juli-au/platonic/img/gallery/v1-poster.jpg

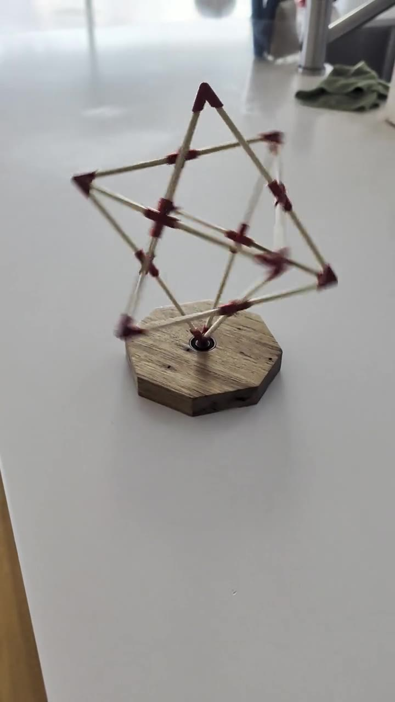
img/gallery/v1-poster.jpg
