juli-au/platonic/img/gallery/g9-thumb.jpg

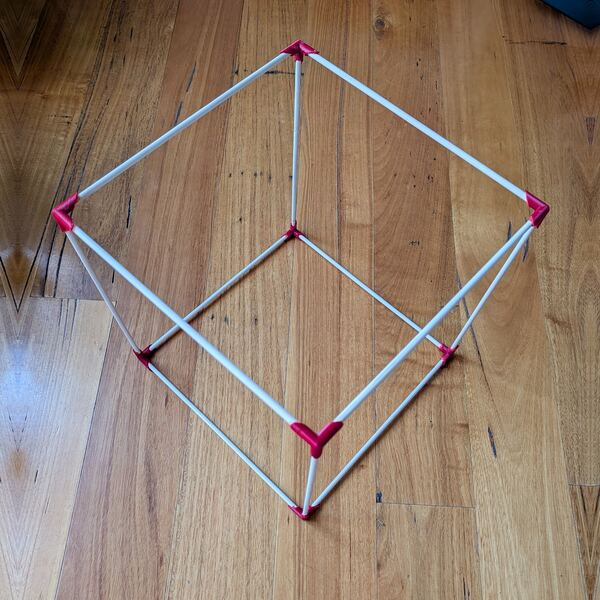
img/gallery/g9-thumb.jpg
