juli-au/platonic/img/gallery/g1-thumb.jpg

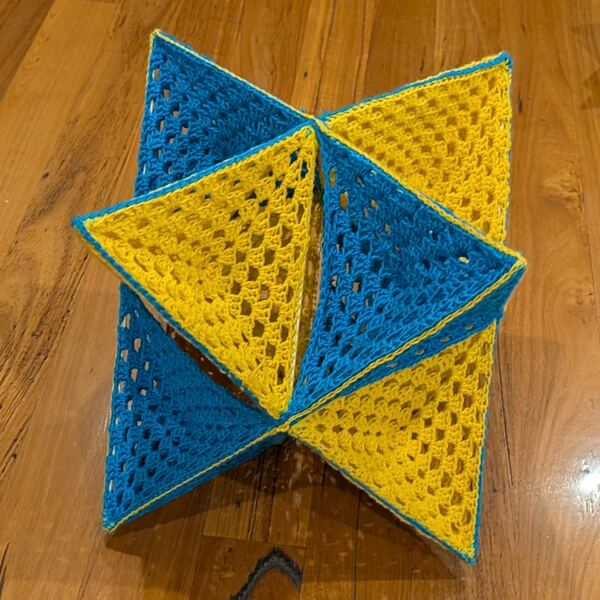
img/gallery/g1-thumb.jpg
