juli-au/platonic/img/gallery/g1.jpg

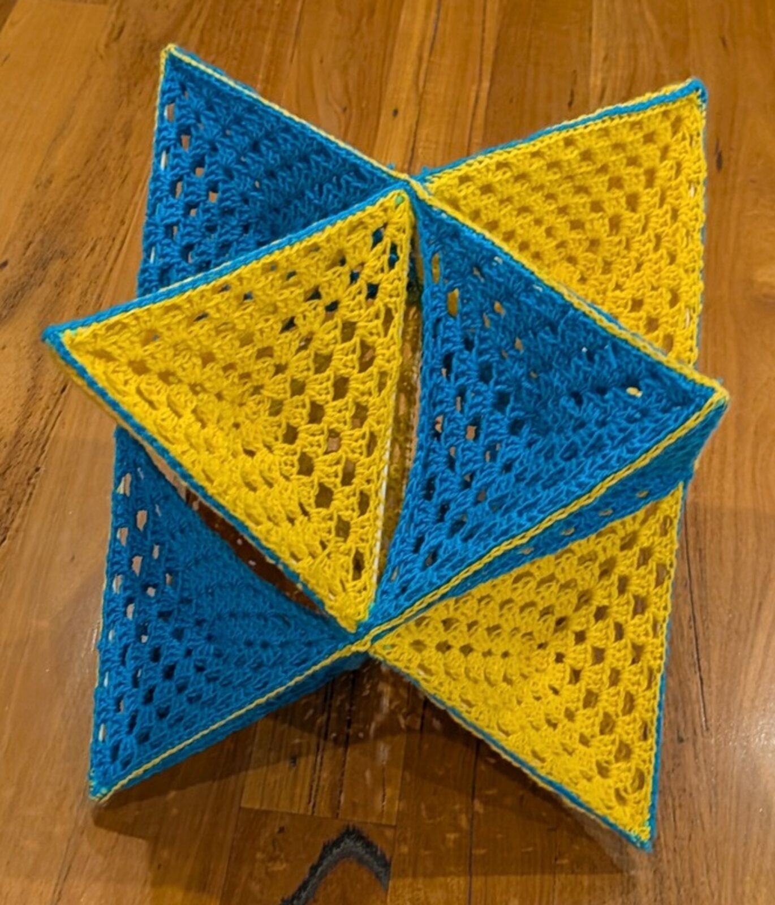
img/gallery/g1.jpg
