juli-au/platonic/img/gallery/g2-thumb.jpg

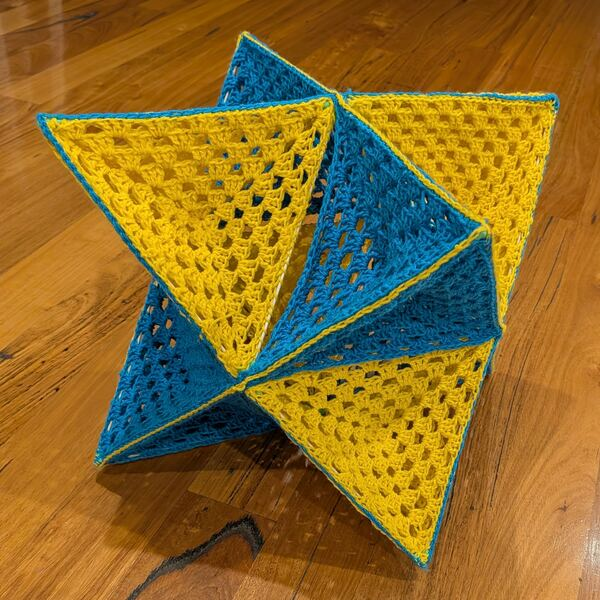
img/gallery/g2-thumb.jpg
