juli-au/platonic/img/gallery/g3-thumb.jpg

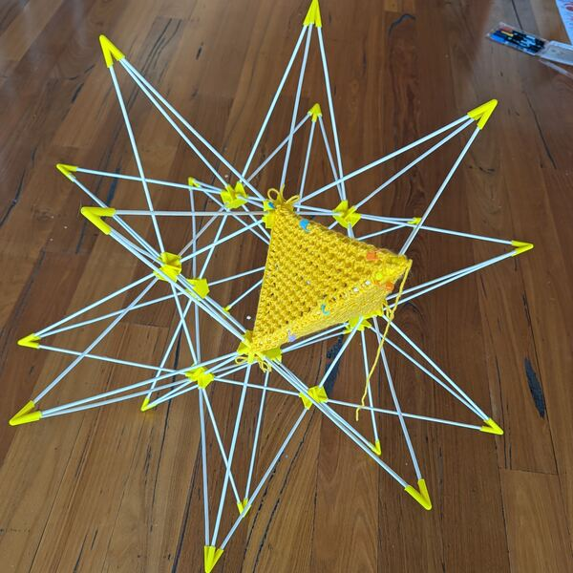
img/gallery/g3-thumb.jpg
