juli-au/platonic/img/gallery/g3.jpg

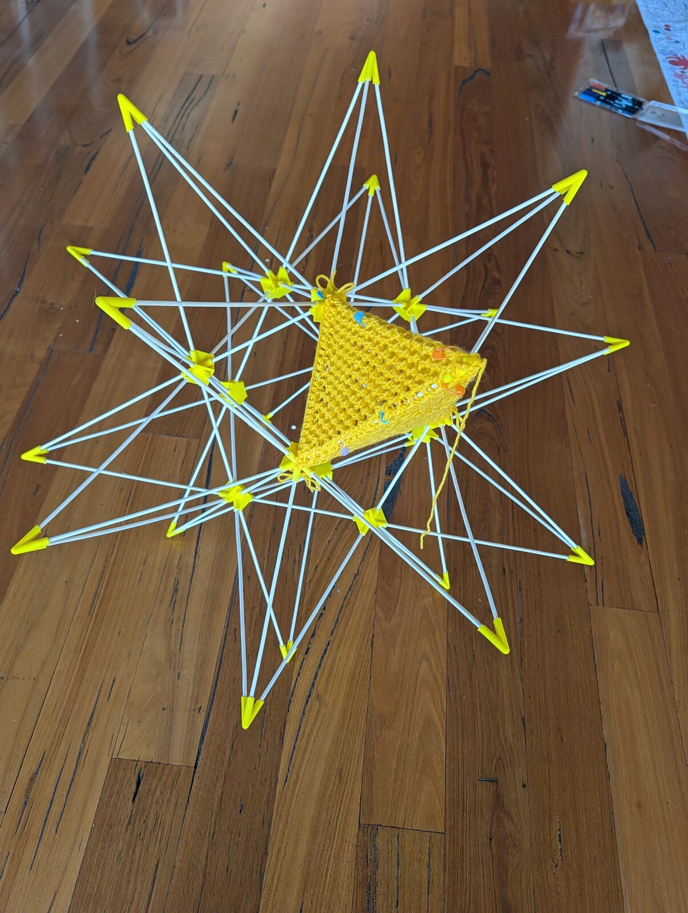
img/gallery/g3.jpg
