juli-au/platonic/img/gallery/g4-thumb.jpg

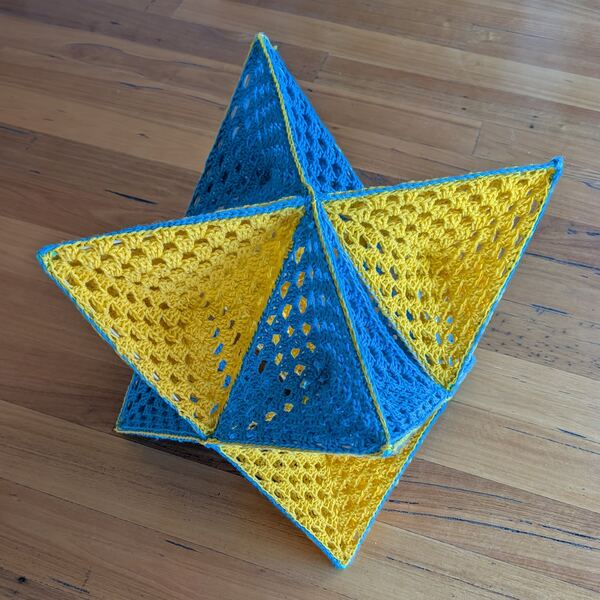
img/gallery/g4-thumb.jpg
