juli-au/platonic/img/gallery/g5-thumb.jpg

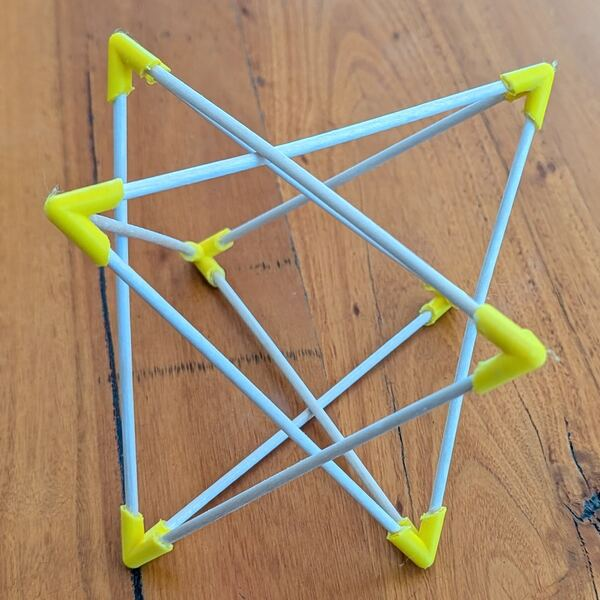
img/gallery/g5-thumb.jpg
