juli-au/platonic/img/gallery/g6-thumb.jpg

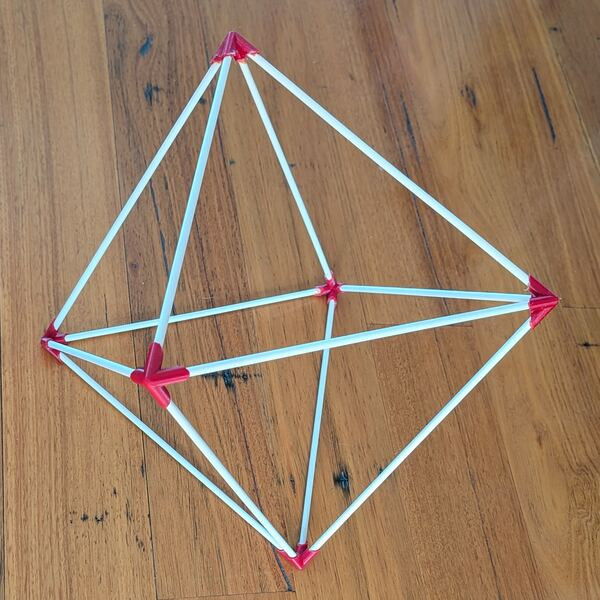
img/gallery/g6-thumb.jpg
