juli-au/platonic/img/gallery/g7-thumb.jpg

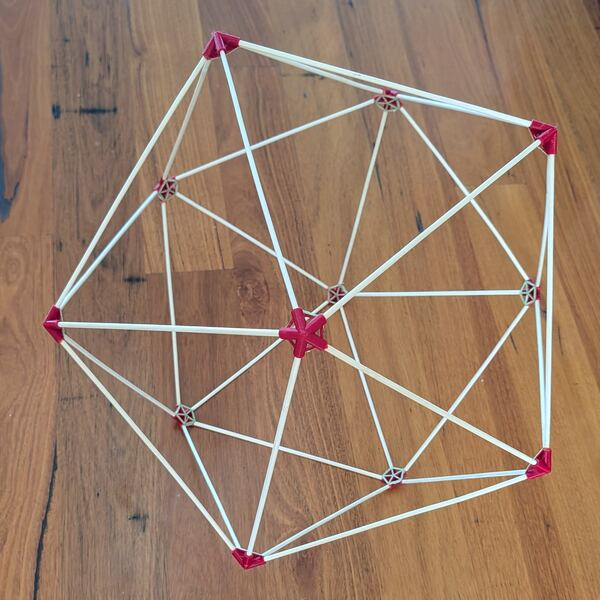
img/gallery/g7-thumb.jpg
