juli-au/platonic/img/gallery/g7.jpg

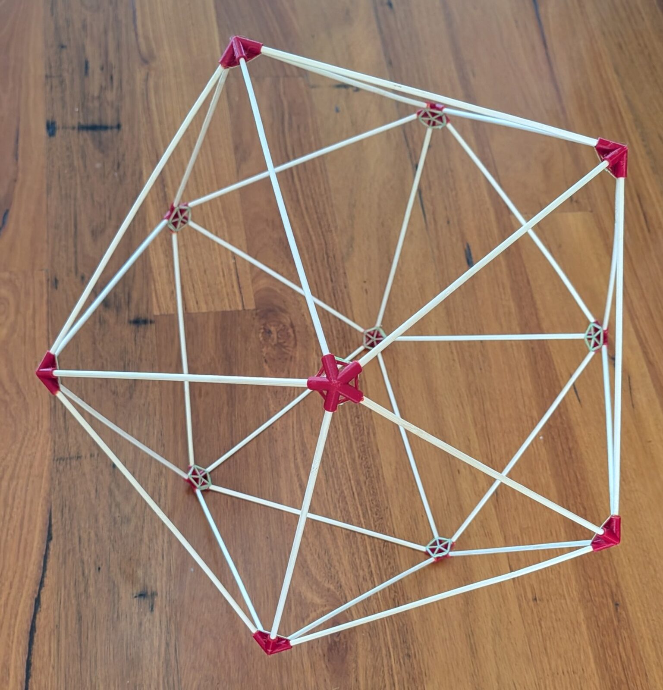
img/gallery/g7.jpg
