juli-au/platonic/img/gallery/g8-thumb.jpg

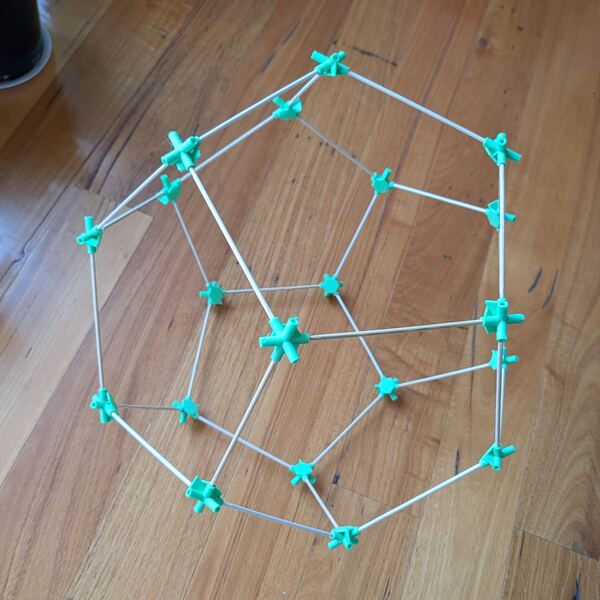
img/gallery/g8-thumb.jpg
