juli-au/platonic/img/gallery/g8.jpg

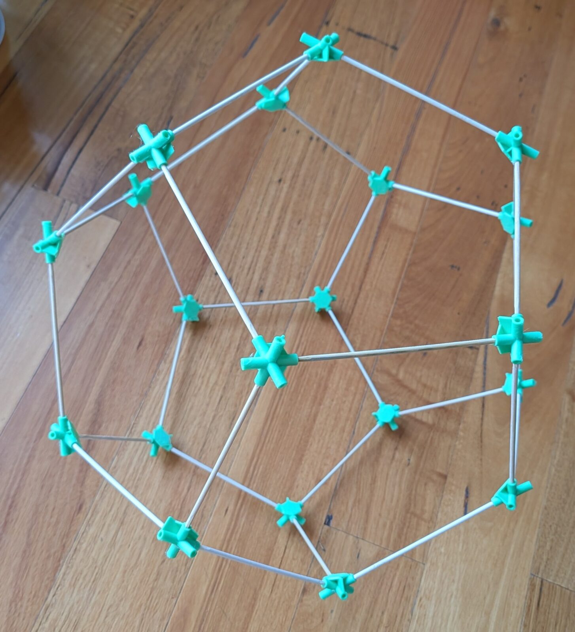
img/gallery/g8.jpg
