juli-au/platonic/img/gallery/g9.jpg

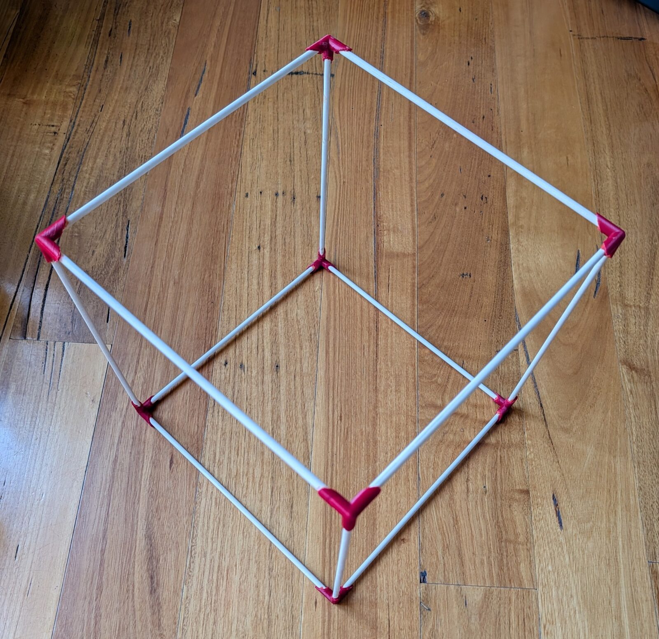
img/gallery/g9.jpg
