juli-au/platonic/img/gallery/g10-thumb.jpg

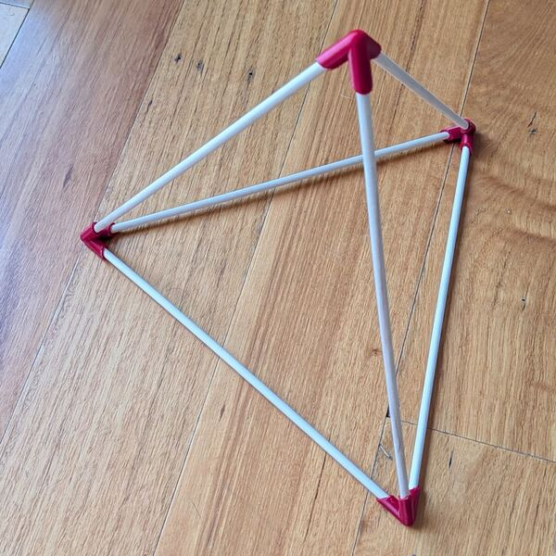
img/gallery/g10-thumb.jpg
