juli-au/platonic/img/gallery/g10.jpg

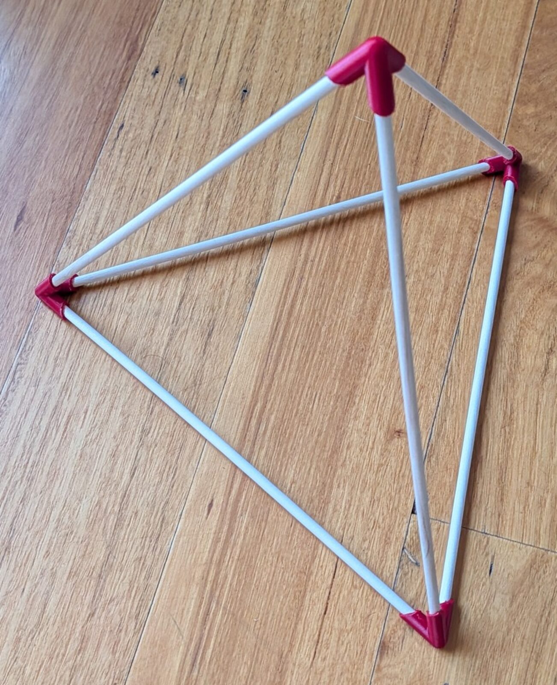
img/gallery/g10.jpg
