juli-au/platonic/img/gallery/g11-thumb.jpg

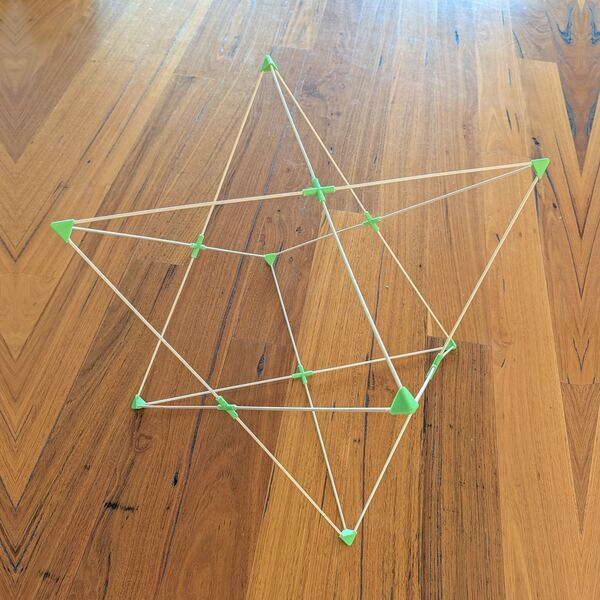
img/gallery/g11-thumb.jpg
