juli-au/platonic/img/gallery/g11.jpg

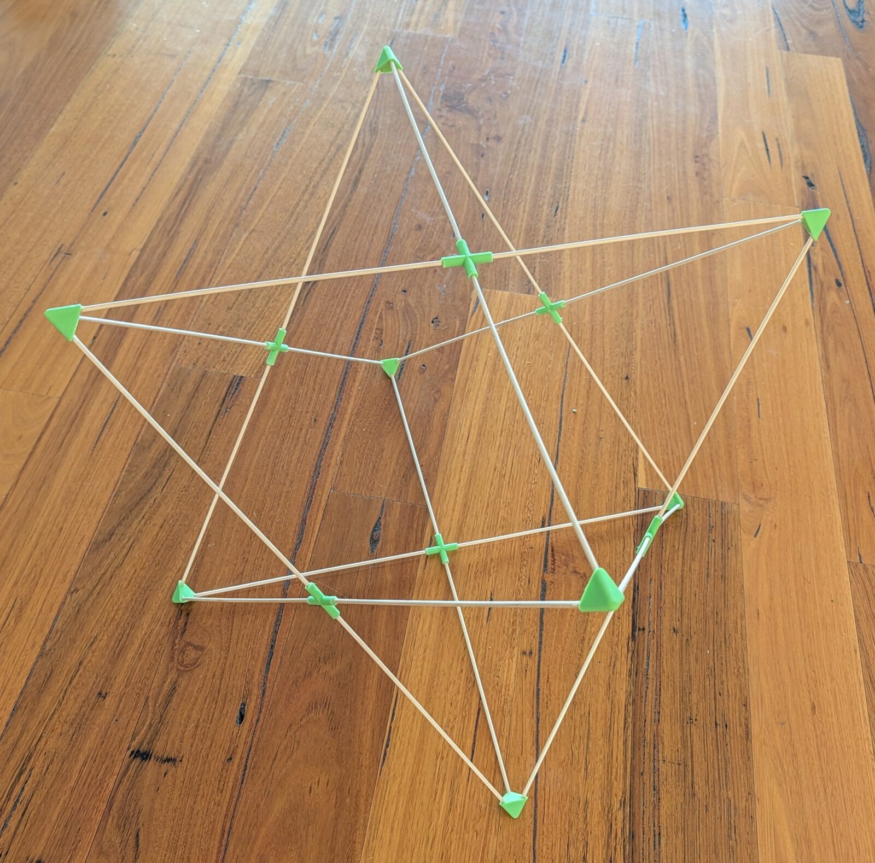
img/gallery/g11.jpg
