juli-au/platonic/img/gallery/g12-thumb.jpg

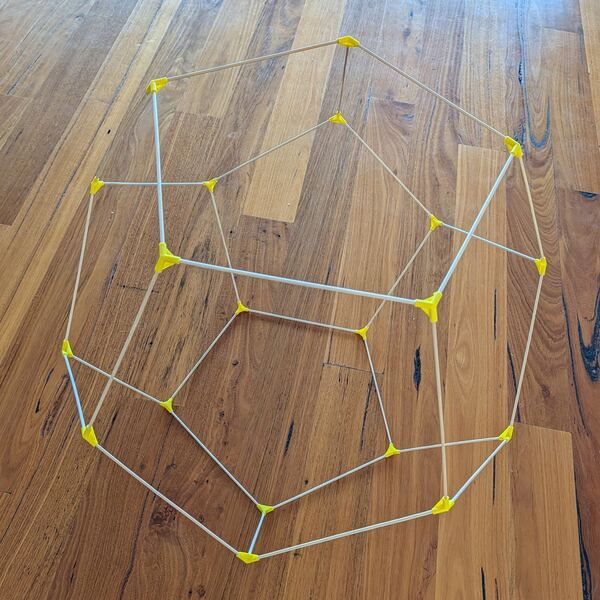
img/gallery/g12-thumb.jpg
