juli-au/platonic/img/gallery/g13-thumb.jpg

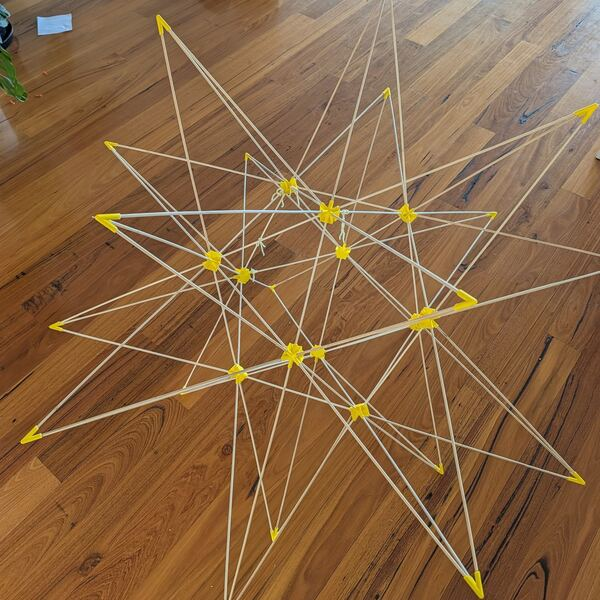
img/gallery/g13-thumb.jpg
