juli-au/platonic/img/gallery/g13.jpg

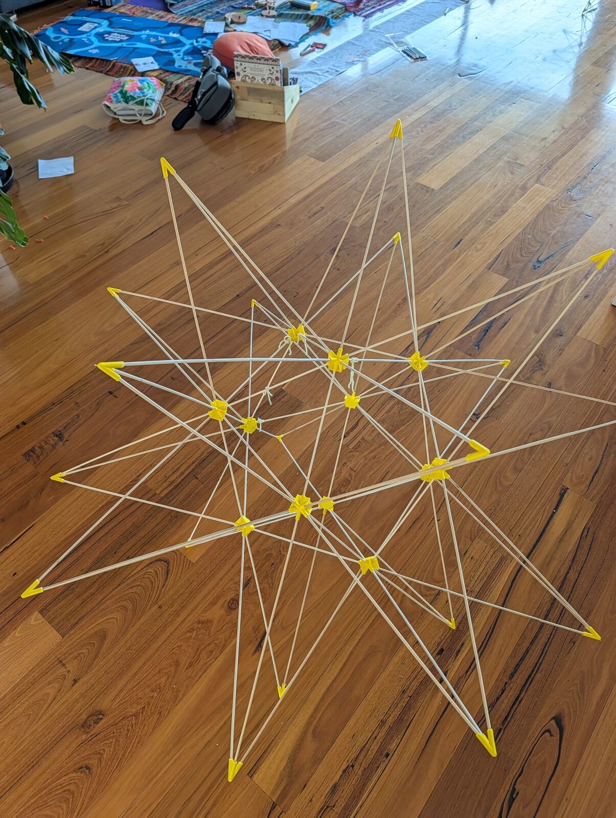
img/gallery/g13.jpg
