juli-au/platonic/img/gallery/g14-thumb.jpg

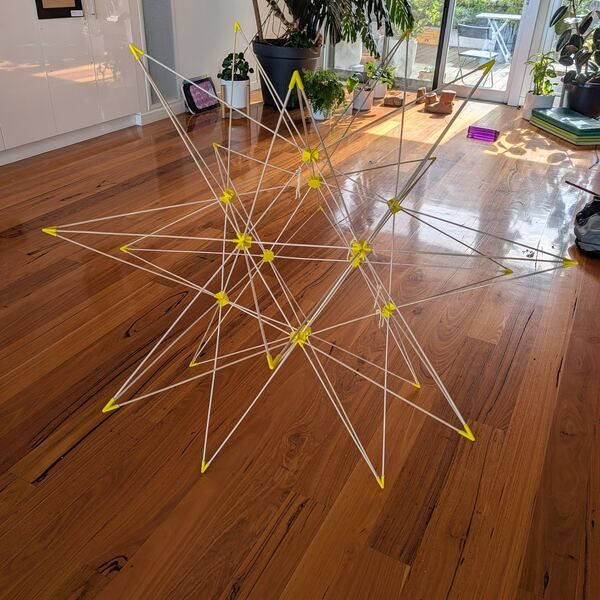
img/gallery/g14-thumb.jpg
