juli-au/platonic/img/gallery/g14.jpg

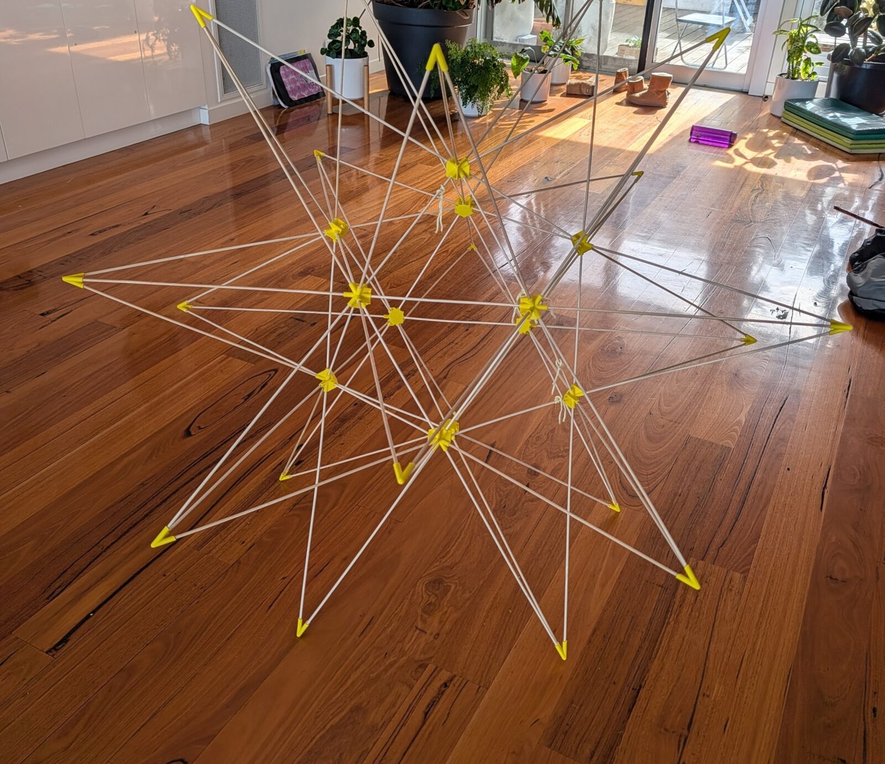
img/gallery/g14.jpg
