juli-au/platonic/img/gallery/g15-thumb.jpg

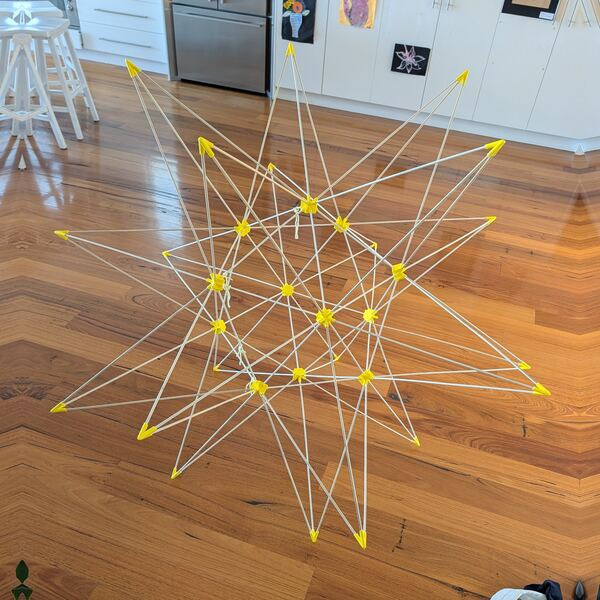
img/gallery/g15-thumb.jpg
