juli-au/platonic/img/gallery/g15.jpg

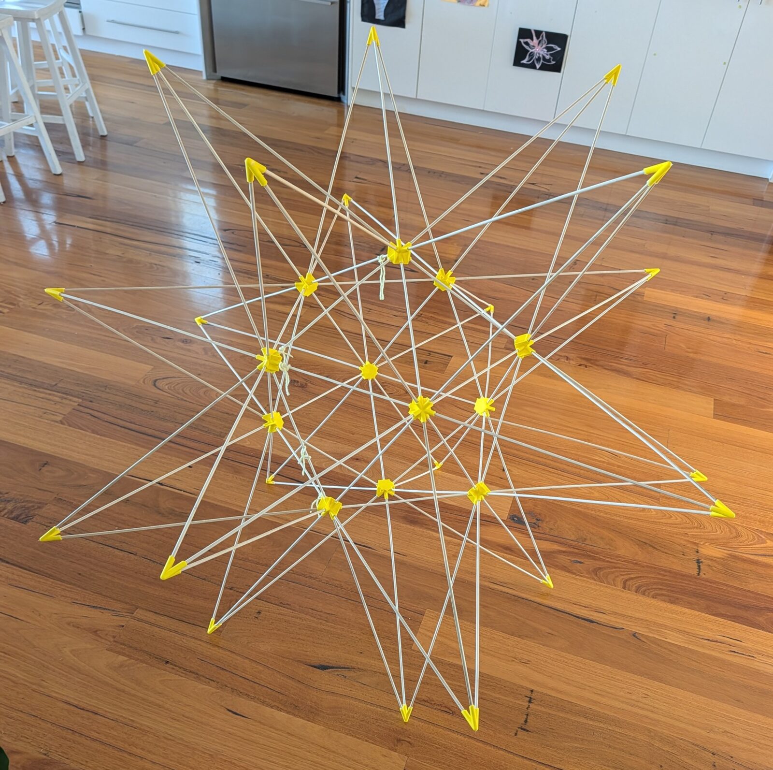
img/gallery/g15.jpg
