juli-au/platonic/img/gallery/v1-thumb.jpg

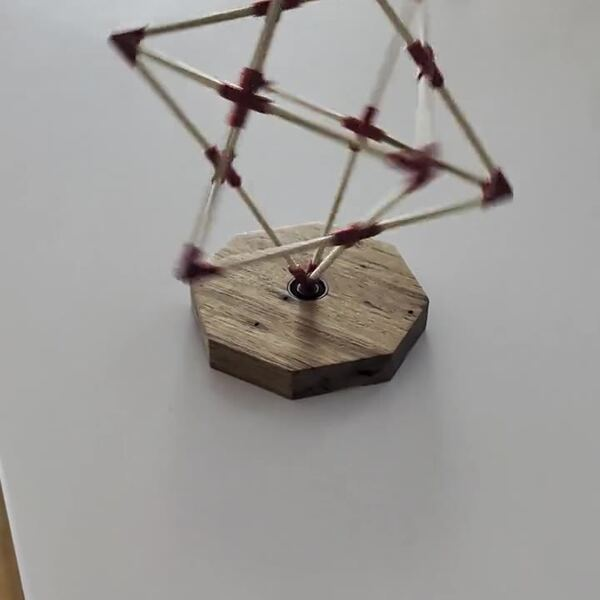
img/gallery/v1-thumb.jpg
