juli-au/platonic/scad/gi_geom.scad

// The visible surface of the great icosahedron: 92 corners and 270
// creases. Coordinates put the twelve tips on the unit sphere. Generated
// by platonic/gi.py; edit that, not this.

// Corner kinds: 0 tip (12), 1 hub (20), 2 corner (60).
gi_kind_r = [1.00000, 0.56278, 0.38445];

// Stake lengths centre to centre, as a fraction of the longest, and the
// two corner kinds each one joins.
gi_len = [1.00000, 0.97720, 0.60394, 0.38197];
gi_len_ends = [[0, 2], [0, 1], [1, 1], [1, 2]];
// The longest stake centre to centre, in units of the tip radius.
gi_longest = 0.665000;

gi_points = [
  [-0.850651, 0.000000, -0.525731],
  [-0.850651, 0.000000, 0.525731],
  [-0.525731, -0.850651, 0.000000],
  [-0.525731, 0.850651, 0.000000],
  [0.000000, -0.525731, -0.850651],
  [0.000000, -0.525731, 0.850651],
  [0.000000, 0.525731, -0.850651],
  [0.000000, 0.525731, 0.850651],
  [0.525731, -0.850651, 0.000000],
  [0.525731, 0.850651, 0.000000],
  [0.850651, 0.000000, -0.525731],
  [0.850651, 0.000000, 0.525731],
  [-0.525731, -0.200811, 0.000000],
  [-0.525731, 0.200811, 0.000000],
  [-0.324920, -0.324920, -0.324920],
  [-0.324920, -0.324920, 0.324920],
  [-0.324920, 0.324920, -0.324920],
  [-0.324920, 0.324920, 0.324920],
  [-0.200811, 0.000000, -0.525731],
  [-0.200811, 0.000000, 0.525731],
  [0.000000, -0.525731, -0.200811],
  [0.000000, -0.525731, 0.200811],
  [0.000000, 0.525731, -0.200811],
  [0.000000, 0.525731, 0.200811],
  [0.200811, 0.000000, -0.525731],
  [0.200811, 0.000000, 0.525731],
  [0.324920, -0.324920, -0.324920],
  [0.324920, -0.324920, 0.324920],
  [0.324920, 0.324920, -0.324920],
  [0.324920, 0.324920, 0.324920],
  [0.525731, -0.200811, 0.000000],
  [0.525731, 0.200811, 0.000000],
  [-0.380423, 0.000000, -0.055503],
  [-0.380423, 0.000000, 0.055503],
  [-0.324920, -0.145308, -0.145308],
  [-0.324920, -0.145308, 0.145308],
  [-0.324920, 0.145308, -0.145308],
  [-0.324920, 0.145308, 0.145308],
  [-0.290617, -0.235114, -0.089805],
  [-0.290617, -0.235114, 0.089805],
  [-0.290617, 0.235114, -0.089805],
  [-0.290617, 0.235114, 0.089805],
  [-0.235114, -0.089805, -0.290617],
  [-0.235114, -0.089805, 0.290617],
  [-0.235114, 0.089805, -0.290617],
  [-0.235114, 0.089805, 0.290617],
  [-0.145308, -0.324920, -0.145308],
  [-0.145308, -0.324920, 0.145308],
  [-0.145308, -0.145308, -0.324920],
  [-0.145308, -0.145308, 0.324920],
  [-0.145308, 0.145308, -0.324920],
  [-0.145308, 0.145308, 0.324920],
  [-0.145308, 0.324920, -0.145308],
  [-0.145308, 0.324920, 0.145308],
  [-0.089805, -0.290617, -0.235114],
  [-0.089805, -0.290617, 0.235114],
  [-0.089805, 0.290617, -0.235114],
  [-0.089805, 0.290617, 0.235114],
  [-0.055503, -0.380423, 0.000000],
  [-0.055503, 0.380423, 0.000000],
  [0.000000, -0.055503, -0.380423],
  [0.000000, -0.055503, 0.380423],
  [0.000000, 0.055503, -0.380423],
  [0.000000, 0.055503, 0.380423],
  [0.055503, -0.380423, 0.000000],
  [0.055503, 0.380423, 0.000000],
  [0.089805, -0.290617, -0.235114],
  [0.089805, -0.290617, 0.235114],
  [0.089805, 0.290617, -0.235114],
  [0.089805, 0.290617, 0.235114],
  [0.145308, -0.324920, -0.145308],
  [0.145308, -0.324920, 0.145308],
  [0.145308, -0.145308, -0.324920],
  [0.145308, -0.145308, 0.324920],
  [0.145308, 0.145308, -0.324920],
  [0.145308, 0.145308, 0.324920],
  [0.145308, 0.324920, -0.145308],
  [0.145308, 0.324920, 0.145308],
  [0.235114, -0.089805, -0.290617],
  [0.235114, -0.089805, 0.290617],
  [0.235114, 0.089805, -0.290617],
  [0.235114, 0.089805, 0.290617],
  [0.290617, -0.235114, -0.089805],
  [0.290617, -0.235114, 0.089805],
  [0.290617, 0.235114, -0.089805],
  [0.290617, 0.235114, 0.089805],
  [0.324920, -0.145308, -0.145308],
  [0.324920, -0.145308, 0.145308],
  [0.324920, 0.145308, -0.145308],
  [0.324920, 0.145308, 0.145308],
  [0.380423, 0.000000, -0.055503],
  [0.380423, 0.000000, 0.055503],
];

// [from, to, length index]
gi_edges = [
  [0, 12, 1],
  [0, 13, 1],
  [0, 14, 1],
  [0, 16, 1],
  [0, 18, 1],
  [0, 32, 0],
  [0, 34, 0],
  [0, 36, 0],
  [0, 42, 0],
  [0, 44, 0],
  [1, 12, 1],
  [1, 13, 1],
  [1, 15, 1],
  [1, 17, 1],
  [1, 19, 1],
  [1, 33, 0],
  [1, 35, 0],
  [1, 37, 0],
  [1, 43, 0],
  [1, 45, 0],
  [2, 12, 1],
  [2, 14, 1],
  [2, 15, 1],
  [2, 20, 1],
  [2, 21, 1],
  [2, 38, 0],
  [2, 39, 0],
  [2, 46, 0],
  [2, 47, 0],
  [2, 58, 0],
  [3, 16, 1],
  [3, 17, 1],
  [3, 22, 1],
  [3, 23, 1],
  [3, 40, 0],
  [3, 41, 0],
  [3, 52, 0],
  [3, 53, 0],
  [3, 59, 0],
  [4, 20, 1],
  [4, 24, 1],
  [4, 26, 1],
  [4, 60, 0],
  [4, 66, 0],
  [4, 72, 0],
  [5, 25, 1],
  [5, 27, 1],
  [5, 61, 0],
  [5, 67, 0],
  [5, 73, 0],
  [6, 22, 1],
  [6, 24, 1],
  [6, 28, 1],
  [6, 68, 0],
  [6, 74, 0],
  [7, 25, 1],
  [7, 29, 1],
  [7, 69, 0],
  [7, 75, 0],
  [8, 30, 1],
  [12, 13, 2],
  [12, 14, 2],
  [12, 15, 2],
  [12, 32, 3],
  [12, 33, 3],
  [12, 34, 3],
  [12, 35, 3],
  [12, 38, 3],
  [12, 39, 3],
  [3, 13, 1],
  [13, 16, 2],
  [13, 17, 2],
  [13, 32, 3],
  [13, 33, 3],
  [13, 36, 3],
  [13, 37, 3],
  [13, 40, 3],
  [13, 41, 3],
  [4, 14, 1],
  [14, 18, 2],
  [14, 20, 2],
  [14, 34, 3],
  [14, 38, 3],
  [14, 42, 3],
  [14, 46, 3],
  [14, 48, 3],
  [14, 54, 3],
  [5, 15, 1],
  [15, 19, 2],
  [15, 21, 2],
  [15, 35, 3],
  [15, 39, 3],
  [15, 43, 3],
  [15, 47, 3],
  [15, 49, 3],
  [15, 55, 3],
  [6, 16, 1],
  [16, 18, 2],
  [16, 22, 2],
  [16, 40, 3],
  [16, 44, 3],
  [16, 50, 3],
  [16, 52, 3],
  [16, 56, 3],
  [7, 17, 1],
  [17, 19, 2],
  [17, 23, 2],
  [17, 41, 3],
  [17, 45, 3],
  [17, 51, 3],
  [17, 53, 3],
  [17, 57, 3],
  [4, 18, 1],
  [6, 18, 1],
  [18, 24, 2],
  [18, 48, 3],
  [18, 50, 3],
  [18, 60, 3],
  [18, 62, 3],
  [5, 19, 1],
  [7, 19, 1],
  [19, 25, 2],
  [19, 49, 3],
  [19, 51, 3],
  [19, 61, 3],
  [19, 63, 3],
  [8, 20, 1],
  [20, 21, 2],
  [20, 26, 2],
  [20, 64, 3],
  [20, 66, 3],
  [20, 70, 3],
  [5, 21, 1],
  [8, 21, 1],
  [21, 27, 2],
  [21, 64, 3],
  [21, 67, 3],
  [21, 71, 3],
  [9, 22, 1],
  [22, 23, 2],
  [22, 28, 2],
  [22, 65, 3],
  [22, 68, 3],
  [22, 76, 3],
  [7, 23, 1],
  [9, 23, 1],
  [23, 29, 2],
  [23, 65, 3],
  [23, 69, 3],
  [23, 77, 3],
  [10, 24, 1],
  [24, 26, 2],
  [24, 28, 2],
  [24, 78, 3],
  [24, 80, 3],
  [11, 25, 1],
  [25, 27, 2],
  [25, 29, 2],
  [25, 79, 3],
  [25, 81, 3],
  [8, 26, 1],
  [10, 26, 1],
  [26, 30, 2],
  [26, 86, 3],
  [8, 27, 1],
  [11, 27, 1],
  [27, 30, 2],
  [27, 87, 3],
  [9, 28, 1],
  [10, 28, 1],
  [28, 31, 2],
  [9, 29, 1],
  [11, 29, 1],
  [29, 31, 2],
  [10, 30, 1],
  [11, 30, 1],
  [30, 31, 2],
  [9, 31, 1],
  [10, 31, 1],
  [11, 31, 1],
  [16, 36, 3],
  [17, 37, 3],
  [18, 42, 3],
  [19, 43, 3],
  [18, 44, 3],
  [19, 45, 3],
  [20, 46, 3],
  [21, 47, 3],
  [4, 48, 0],
  [5, 49, 0],
  [6, 50, 0],
  [7, 51, 0],
  [22, 52, 3],
  [23, 53, 3],
  [4, 54, 0],
  [20, 54, 3],
  [5, 55, 0],
  [21, 55, 3],
  [6, 56, 0],
  [22, 56, 3],
  [7, 57, 0],
  [23, 57, 3],
  [20, 58, 3],
  [21, 58, 3],
  [22, 59, 3],
  [23, 59, 3],
  [24, 60, 3],
  [25, 61, 3],
  [6, 62, 0],
  [24, 62, 3],
  [7, 63, 0],
  [25, 63, 3],
  [8, 64, 0],
  [9, 65, 0],
  [26, 66, 3],
  [27, 67, 3],
  [28, 68, 3],
  [29, 69, 3],
  [8, 70, 0],
  [26, 70, 3],
  [8, 71, 0],
  [27, 71, 3],
  [24, 72, 3],
  [26, 72, 3],
  [25, 73, 3],
  [27, 73, 3],
  [24, 74, 3],
  [28, 74, 3],
  [25, 75, 3],
  [29, 75, 3],
  [9, 76, 0],
  [28, 76, 3],
  [9, 77, 0],
  [29, 77, 3],
  [10, 78, 0],
  [26, 78, 3],
  [11, 79, 0],
  [27, 79, 3],
  [10, 80, 0],
  [28, 80, 3],
  [11, 81, 0],
  [29, 81, 3],
  [8, 82, 0],
  [26, 82, 3],
  [30, 82, 3],
  [8, 83, 0],
  [27, 83, 3],
  [30, 83, 3],
  [9, 84, 0],
  [28, 84, 3],
  [31, 84, 3],
  [9, 85, 0],
  [29, 85, 3],
  [31, 85, 3],
  [10, 86, 0],
  [30, 86, 3],
  [11, 87, 0],
  [30, 87, 3],
  [10, 88, 0],
  [28, 88, 3],
  [31, 88, 3],
  [11, 89, 0],
  [29, 89, 3],
  [31, 89, 3],
  [10, 90, 0],
  [30, 90, 3],
  [31, 90, 3],
  [11, 91, 0],
  [30, 91, 3],
  [31, 91, 3],
];

// The twenty big triangles, as indices into the first twelve points.
gi_faces = [
  [7, 8, 6],
  [7, 6, 2],
  [7, 0, 8],
  [7, 2, 10],
  [7, 10, 0],
  [9, 1, 8],
  [9, 8, 0],
  [9, 4, 1],
  [9, 5, 4],
  [9, 0, 5],
  [11, 6, 1],
  [11, 2, 6],
  [11, 1, 4],
  [11, 4, 3],
  [11, 3, 2],
  [6, 8, 1],
  [5, 10, 3],
  [5, 3, 4],
  [5, 0, 10],
  [3, 10, 2],
];

// One corner of each kind: the direction and length index of every
// stake leaving it, with the outward radial on +z.
gi_tip_dirs = [
  [[0.525731, 0.000000, -0.850651], 1],
  [[0.162460, 0.500000, -0.850651], 1],
  [[0.185874, 0.135045, -0.973249], 0],
  [[0.162460, -0.500000, -0.850651], 1],
  [[0.185874, -0.135045, -0.973249], 0],
  [[-0.070997, 0.218508, -0.973249], 0],
  [[-0.425325, 0.309017, -0.850651], 1],
  [[-0.070997, -0.218508, -0.973249], 0],
  [[-0.229752, 0.000000, -0.973249], 0],
  [[-0.425325, -0.309017, -0.850651], 1],
];
gi_hub_dirs = [
  [[0.934172, 0.000000, 0.356822], 1],
  [[-0.467086, -0.809017, 0.356822], 1],
  [[-0.467086, 0.809017, 0.356822], 1],
  [[0.467086, -0.809017, -0.356822], 2],
  [[0.456436, -0.353553, -0.816496], 3],
  [[0.077968, -0.572062, -0.816496], 3],
  [[0.467086, 0.809017, -0.356822], 2],
  [[-0.934172, 0.000000, -0.356822], 2],
  [[0.456435, 0.353553, -0.816497], 3],
  [[-0.534403, -0.218508, -0.816497], 3],
  [[0.077967, 0.572062, -0.816497], 3],
  [[-0.534403, 0.218509, -0.816497], 3],
];
gi_corner_dirs = [
  [[0.597614, 0.000000, 0.801784], 0],
  [[-0.298808, 0.790570, 0.534522], 3],
  [[-0.298808, -0.790570, 0.534522], 3],
];
