juli-au/platonic/(list of files, cad)

Other CAD files:
scad/icosa.scad
scad/octa.scad
