juli-au/platonic/(commit log)

2026-10-11 Start platonic, a connector generator for polyhedra
    The site lets people pick one of the dowel-connector designs from yarnitti/platonic, set the dowel size, length, bore clearance and wall, and download the STL. It is built on twirly's layout and viewer.
    It vendors openscad-wasm 0.0.4 (OpenSCAD 2025.07 with Manifold) in place of twirly's 2022.03 build, because the hubs took 13 to 25 seconds to render there and take under half a second now. The icosahedron vertex swaps projection() for a flattened copy of the arm, because the browser build crashes on it. The footprint is the same, and desktop OpenSCAD gives the same volume and size for both.
2026-10-11 Light theme, more dowel sizes
    The site gets its own look, a light paper background with an ink-blue accent and the controls on the right, so it does not read as a copy of twirly.
    Dowels now run from 3 mm to 10 mm. Sockets get deeper for thick dowels, base plates and gussets scale with the bore, and the cutters that flatten each part on the bed are large enough for the biggest parts. Every part renders as a single piece at every size with desktop OpenSCAD, but only 4 mm and 5 mm have been printed, and the page says so.
2026-10-12 Add part tabs, the assembled view and stella octangula
    Each figure now has a tab for the assembled frame and one per printed part. The assembled frame is drawn in three.js from the connector positions, with each connector in its part's colour, so it shows at once without an OpenSCAD run. The facts list how many connectors and dowels the figure takes, and the dowel lengths.
    The length slider can set the longest or the shortest stake. Every stake length is a straight-line function of the longest one, so two echo-only runs give the map from one to the other.
    The stella octangula comes in two versions, with and without the inner octahedron, from the round-stake modules in yarnitti's platonic.s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
2026-10-12 Show the solid's faces in the assembled view
    Semi-transparent faces make the star shapes easier to read than rods alone. The star frames get their visible triangles from the face each point stands on, the great icosahedron uses the face list in gi_geom.scad, and the convex solids and the two stella tetrahedra use three.js's convex hull. A faces switch next to the tabs turns them off.
2026-10-12 Show or hide each part in the assembled view
    On figures with several connector kinds, a row of switches under the tabs hides a kind together with every stake that ends in it. With the hubs hidden the great icosahedron shows its star points and flute corners on their own, and with only the hubs shown it shows the dodecahedron core, which makes it easier to see how the frame goes together. The faces switch moves into the same row.
    The phone-size styles had picked up a second copy of the tab styles; they are back to the phone overrides alone.
2026-10-12 Download every part from the assembled view
    On the assembled view the download button renders each part with the current settings and saves it as its own STL, so a whole figure is one click. The files start a moment apart, because browsers drop downloads that start together.
    The tagline now reads "Platonic solids and their stellar friends".
2026-10-12 Offer 2 mm dowels
    Thin dowels such as 2 mm bamboo make small desk-sized figures. Every part renders as a single piece at 2 mm with desktop OpenSCAD; like the other sizes besides 4 mm and 5 mm, it has not been printed yet.
2026-10-12 Capitalise the name, try out heading fonts
    The heading now reads Platonic. A row of seven heading fonts at the bottom of the panel lets the font be picked on the live page, and the choice is kept in the browser. The row comes out again once a font is chosen.
    The assembled view's download button says "Download all", so the label fits on one line.
2026-10-12 Show the core solid in the assembled view
    Each star frame is built on a dodecahedron, an icosahedron or, for the stella octangula, an octahedron, whose corners are the hub connectors. A switch under the tabs draws that solid as a violet hull with its edges outlined, which shows what the stars stand on.
    Faces in the assembled view are now off by default, so the frame shows first.
2026-10-12 Lay the facts out as a table
    The connectors, dowels and frame size now sit in three sections with the counts in a right-hand column, which reads like a shopping list. The part on screen is highlighted, and notes such as untested sizes go underneath.
2026-10-12 Show the faces each figure is named after
    A figure's name counts its faces: the great dodecahedron has twelve big pentagons that pass through each other, and the dimples are where they cut into each other. A true faces switch draws those faces faintly and steps a strong highlight from one to the next every second, so they can be counted. The stars' faces are found as the widest ring of five corners along each five-fold axis; the convex solids' as the planes with every corner on one side.
    The figure's name now shows as a heading on the drawing area, the facts table gives the face count, and the counts and lengths in the table drop the × and the word long.
2026-10-12 One faces switch where the faces are the true faces
    On the Platonic solids and the stella octangula the visible faces are the faces the name counts, so a single faces (N) switch shows them with the counting highlight. The four stars keep both switches.
2026-10-12 Step between figures, add the dedication
    Two chevron buttons in one pill to the left of the figure name step to the previous or next figure, as do the arrow keys, so the figures can be browsed without the dropdown. The buttons sit before the name so they stay put as the name changes length.
    The footer gets a dedication to Mali and Anika, who helped assemble the figures.
2026-10-12 Add a photo gallery
    The builder shows what the connectors make on screen, but not what the
    built figures look like. The gallery shows photos of the solids and stars
    built at home, and a video of a star spinning on its base. A link under
    the tagline in the builder's panel opens it.
    The photos are cropped to each figure and resized to 1600 px on the long
    side. The video is re-encoded at 720 px wide without sound.
